rjw57/buri-bus-monitor/front-panel-mirror.pdf

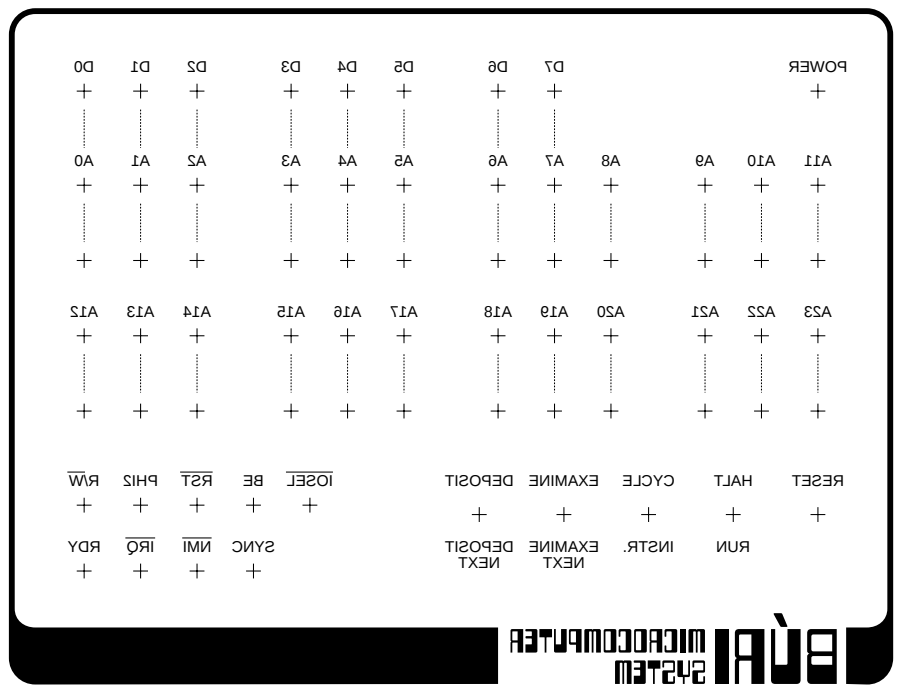
[picture p1: page 1]
