rjw57/buri-bus-monitor/front-panel.pdf

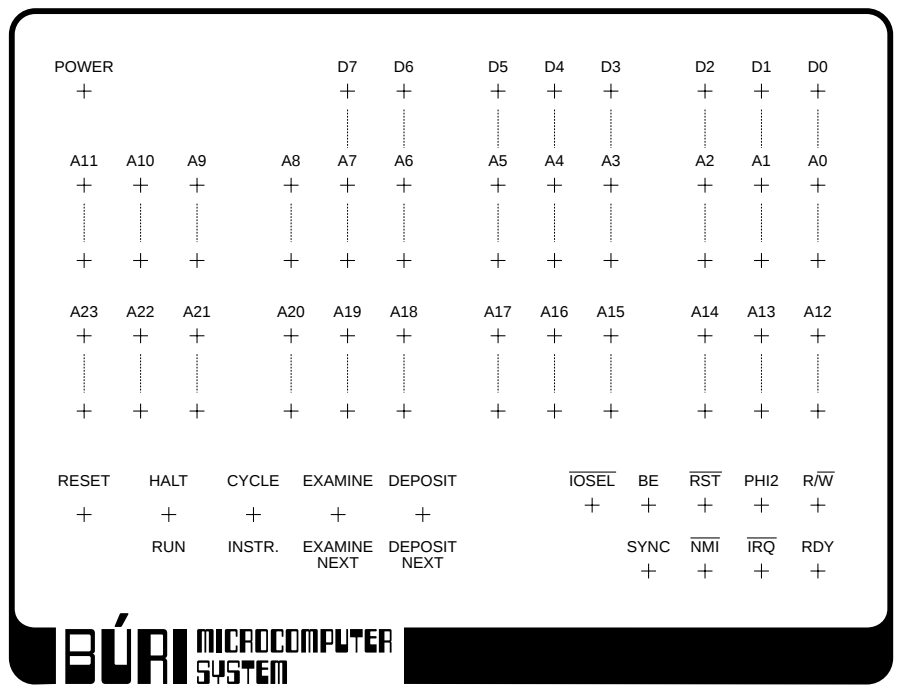
[picture p2: page 1]
