rjw57/buri-bus-monitor/plot/buri-bus-monitor.pdf

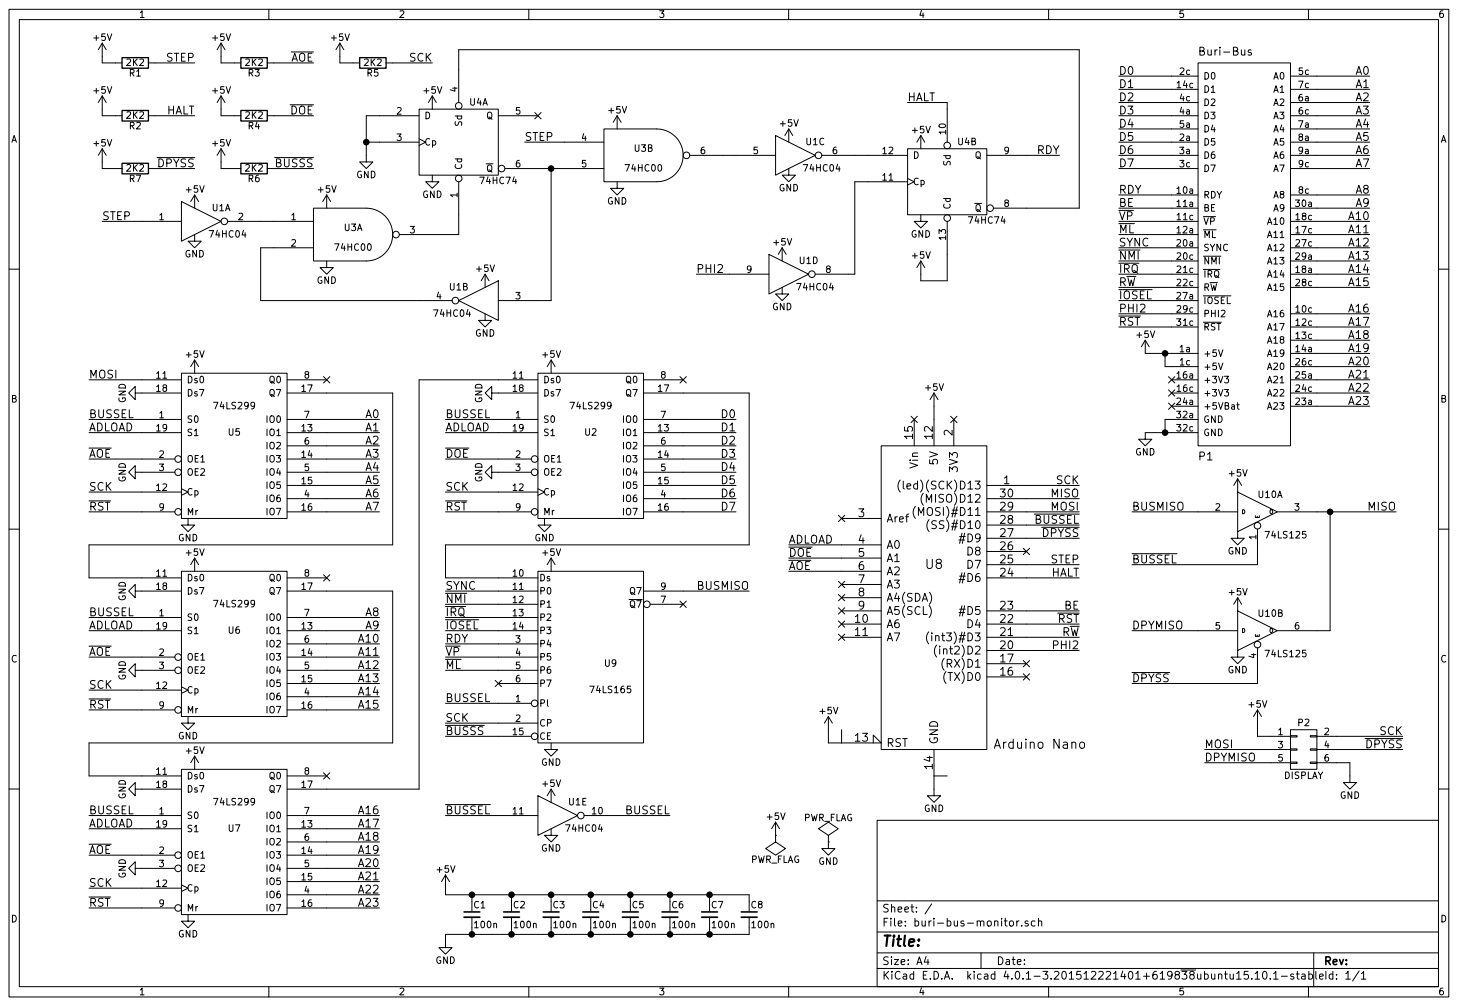
[picture p3: page 1]

Id: 1/1 Title: File: buri-bus-monitor.sch Sheet: /
