rjw57/buri-bus-monitor/plot/buri-bus-monitor-B.Cu.pdf

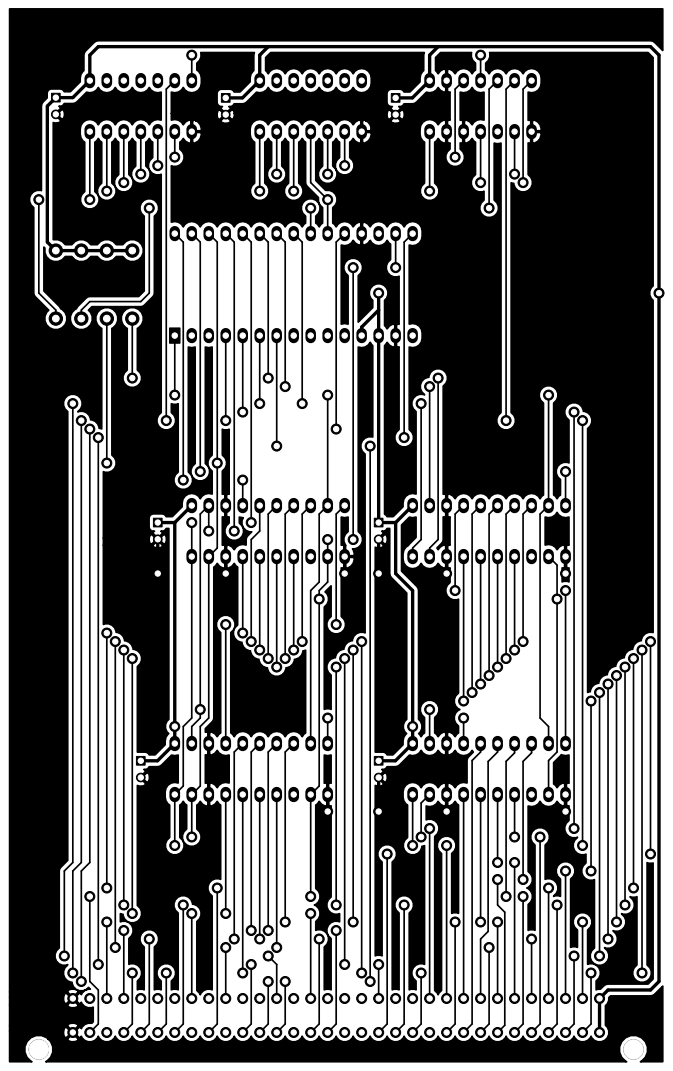
[picture p4: page 1]
