rjw57/buri-bus-monitor/plot/buri-bus-monitor-F.Cu.pdf

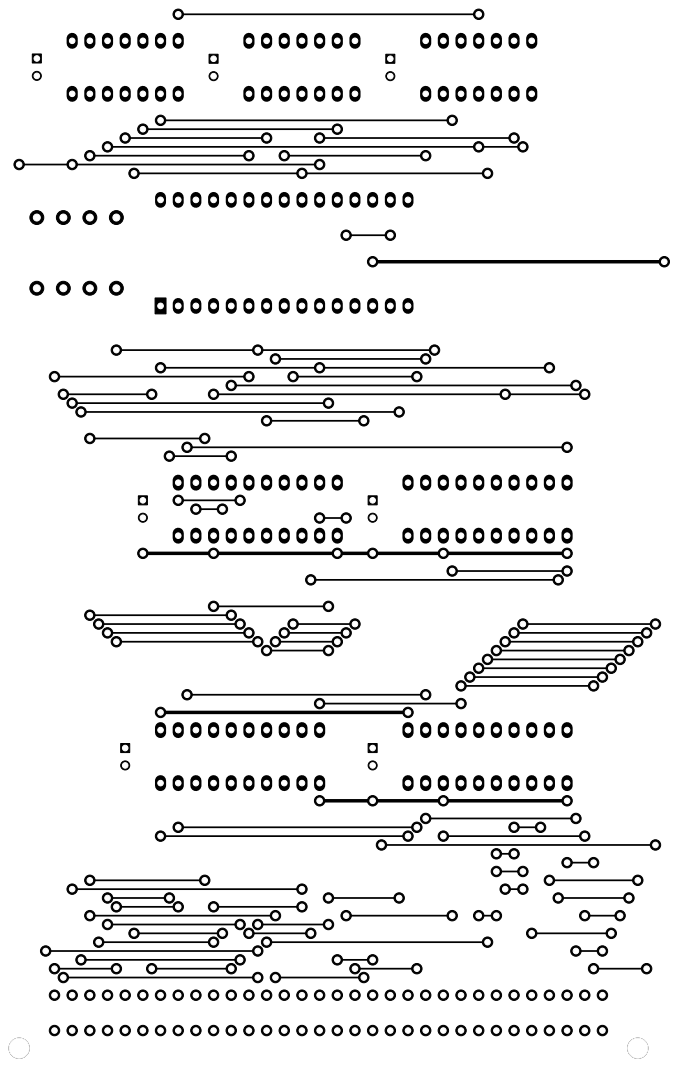
[picture p5: page 1]
