rjw57/buri-bus-monitor/plot/buri-bus-monitor-F.SilkS.pdf

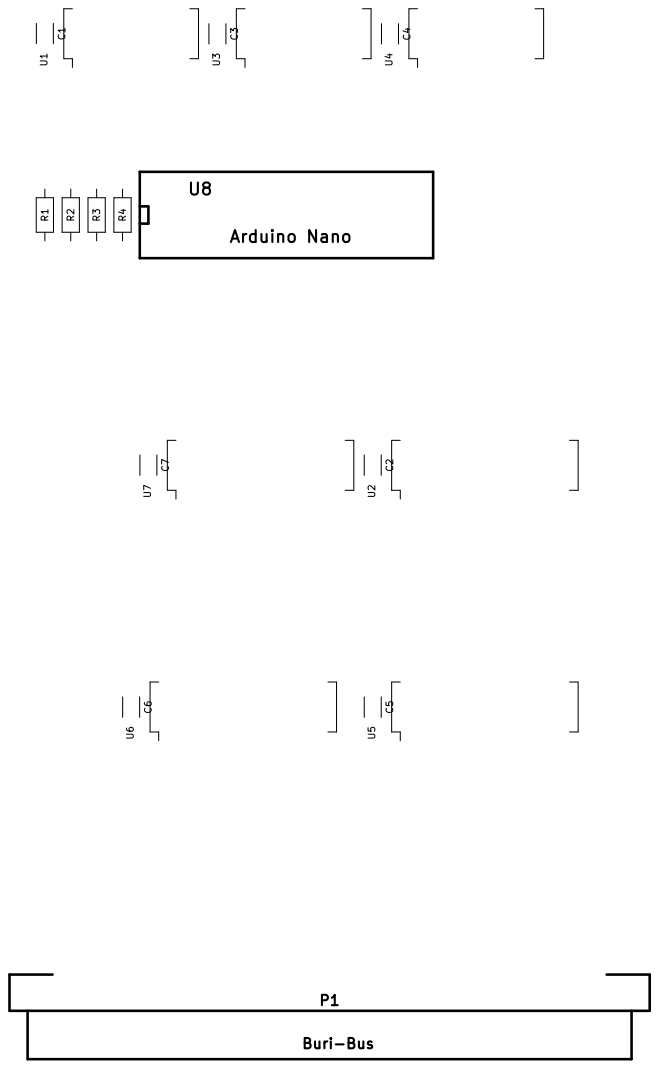
[picture p6: page 1]
