rjw57/buri-bus-monitor/buri-bus-monitor.kicad_pcb

## KiCad design buri-bus-monitor.kicad_pcb (2016-01-09)

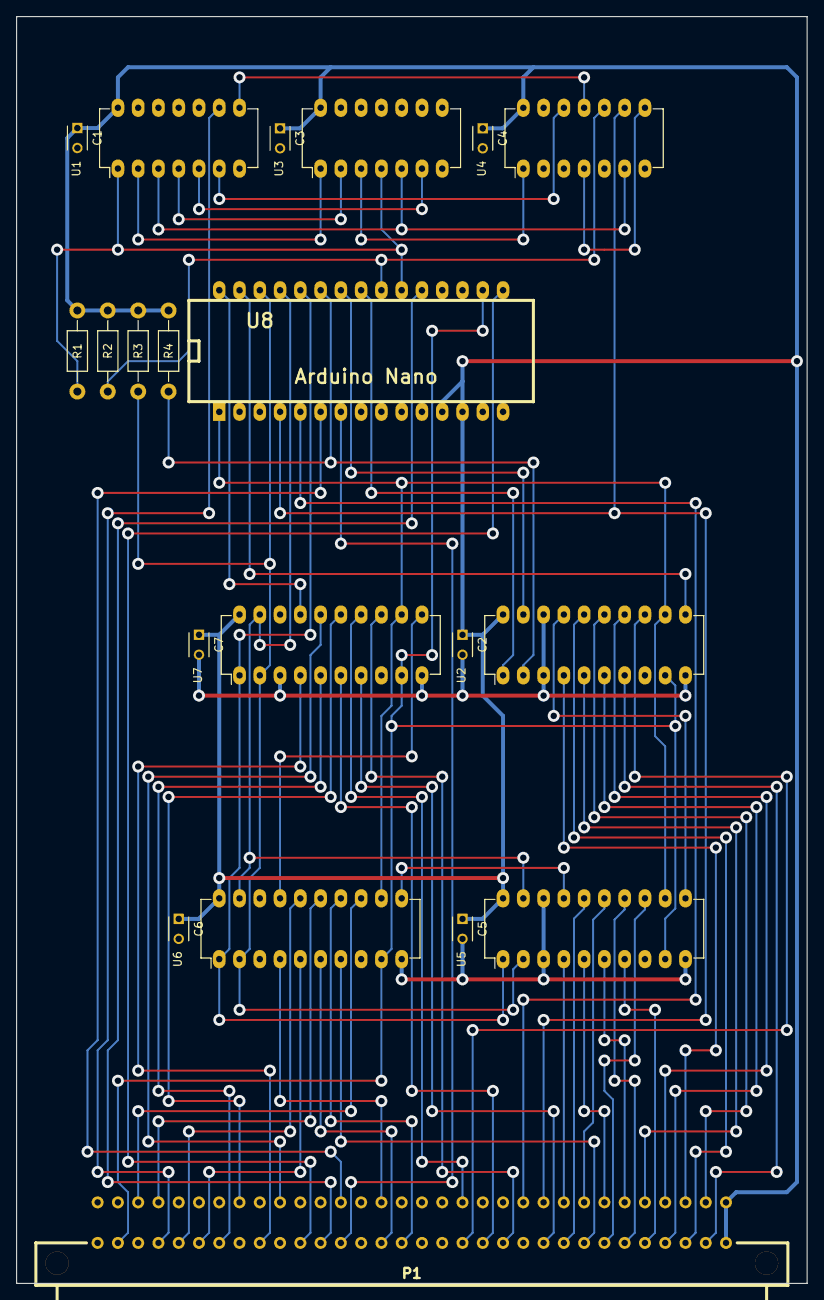
[picture p7: board buri-bus-monitor.kicad_pcb from above]

Board: 2 copper layers, 99.1 x 158.8 mm, 20 parts (0 on the bottom side), 64 nets.

Parts:
C1, C2, C3, C4, C5, C6, C7: 100n; C_Disc_D3_P2.5
P1: Buri-Bus; buri-bus-male
R1, R2, R3, R4: 3K3; Resistor_Horizontal_RM10mm
U1: 74HC04; DIP-14_W7.62mm_LongPads
U2, U5, U6, U7: 74LS299; DIP-20_W7.62mm_LongPads
U3: 74HC00; DIP-14_W7.62mm_LongPads
U4: 74HC74; DIP-14_W7.62mm_LongPads
U8: Arduino Nano; arduino_mini

Connections:
+5V: C1.1, C2.1, C3.1, C4.1, C5.1, C6.1, C7.1, P1.1a, P1.1c, R1.2, R2.2, R3.2, R4.2, U1.14, U2.20, U3.14, U4.13, U4.14, U5.20, U6.20, U7.20, U8.12, U8.13
/A0: P1.5c, U5.7
/A1: P1.7c, U5.13
/A2: P1.6a, U5.6
/A3: P1.6c, U5.14
/A4: P1.7a, U5.5
/A5: P1.8a, U5.15
/A6: P1.9a, U5.4
/A7: P1.9c, U5.16
/A8: P1.8c, U6.7
/A9: P1.30a, U6.13
/A10: P1.18c, U6.6
/A11: P1.17c, U6.14
/A12: P1.27c, U6.5
/A13: P1.29a, U6.15
/A14: P1.18a, U6.4
/A15: P1.28c, U6.16
/A16: P1.10c, U7.7
/A17: P1.12c, U7.13
/A18: P1.13c, U7.6
/A19: P1.14a, U7.14
/A20: P1.26c, U7.5
/A21: P1.25a, U7.15
/A22: P1.24c, U7.4
/A23: P1.23a, U7.16
/AS0: U5.1, U6.1, U7.1, U8.26
/AS1: U5.19, U6.19, U7.19, U8.27
/BE: P1.11a, U8.5
/D0: P1.2c, U2.7
/D1: P1.14c, U2.13
/D2: P1.4c, U2.6
/D3: P1.4a, U2.14
/D4: P1.5a, U2.5
/D5: P1.2a, U2.15
/D6: P1.3a, U2.4
/D7: P1.3c, U2.16
/DS0: U2.1, U8.23
/DS1: U2.19, U8.24
/HALT: R2.1, U4.10, U8.22
/MISO: U7.17, U8.30
/MOSI: U2.11, U8.29
/PHI2: P1.29c, U1.9
/RDY: P1.10a, U4.9, U8.4
/R~W: P1.22c, U8.16
/SCLK: U2.12, U5.12, U6.12, U7.12, U8.1
/STEP: R1.1, U1.1, U3.4, U8.21
/SYNC: P1.20a, U8.6
/~AOE: R3.1, U5.2, U6.2, U7.2, U8.28
/~DOE: R4.1, U2.2, U8.25
/~IRQ: P1.21c, U8.20
/~NMI: P1.20c, U8.7
/~RST: P1.31c, U2.9, U5.9, U6.9, U7.9, U8.17
GND: C1.2, C2.2, C3.2, C4.2, C5.2, C6.2, C7.2, P1.32a, P1.32c, U1.7, U2.3, U2.10, U2.18, U3.7, U4.2, U4.3, U4.7, U5.3, U5.10, U5.18, U6.3, U6.10, U6.18, U7.3, U7.10, U7.18, U8.14, U8.19
unnamed: U1.2, U3.1
unnamed: U1.3, U3.5, U4.6
unnamed: U1.4, U3.2
unnamed: U1.5, U3.6
unnamed: U1.6, U4.12
unnamed: U1.8, U4.11
unnamed: U2.17, U5.11
unnamed: U3.3, U4.1
unnamed: U4.4, U4.8
unnamed: U5.17, U6.11
unnamed: U6.17, U7.11
