rjw57/buri-bus-monitor/dumb-firmware/serialcli.cpp

#include "serialcli.h"

#include <stdlib.h>
#include <string.h>

#include "control.h"
#include "globals.h"
#include "serialstatemachine.h"

const int MAX_CMD_LEN = 127, MAX_TOKENS = 5;
byte cmd_buf[MAX_CMD_LEN+1];
byte* cmd_tokenv[MAX_TOKENS+1];
int cmd_len;

// Address to write next upload line to
unsigned int upload_addr;

// States
static SerialState readingCommandState(byte ch);

// Process command stored in cmd_buf and return state to transition to.
static SerialState processCommand();

// Print a brief usage summary to the serial port.
static void printHelp();

// EXTERNAL

SerialState startSerialPrompt() {
    // Reset current command
    cmd_buf[0] = '\0';
    cmd_len = 0;

    Serial.print("> ");
    return { .next = &readingCommandState };
}

// INTERNAL

const char hexDigits[] = "0123456789ABCDEF";
static void printByteHex(byte v) {
    Serial.print(hexDigits[(v>>4) & 0xF]);
    Serial.print(hexDigits[v & 0xF]);
}

static void printWordHex(unsigned int v) {
    printByteHex((v>>8) & 0xFF);
    printByteHex(v & 0xFF);
}

// Handle input from serial and update input_len/inpit_buf appropriately.
// Return true if command has been entered.
static bool lineEditor(byte ch, byte* input_buf, int &input_len) {
    switch(ch) {
        // handle backspace
        case 8:
        case 127:
            if(input_len > 0) {
                Serial.write(8);
                Serial.write(' ');
                Serial.write(8);
                input_len--;
                input_buf[input_len] = '\0';
            } else {
                // bell
                Serial.write(7);
            }
            break;

        // handle enter
        case 10:
        case 13:
            Serial.println("");
            return true;
            break;

        default:
            // Only accept printable chars.
            if(ch < 0x20) {
                // Bell
                Serial.write(7);
            } else if(input_len < MAX_CMD_LEN) {
                // Add character to command buffer
                input_buf[input_len] = ch;
                input_len++;
                input_buf[input_len] = '\0';

                // Echo character to output
                Serial.write(ch);
            } else {
                // Bell
                Serial.write(7);
            }
            break;
    }

    return false;
}

// State machine
static SerialState readingCommandState(byte ch) {
    if(lineEditor(ch, cmd_buf, cmd_len)) {
        return processCommand();
    }

    return { .next = &readingCommandState };
}

#if 0
static void processUploadLine() {
    // Iterate through cmd_buf parsing any hex chars
    bool high_nibble=true;
    byte current_byte=0;
    startMem();
    for(int n=0; (n < cmd_len) && (cmd_buf[n] != '\0'); ++n) {
        byte nibble=0, c=cmd_buf[n];

        if((c >= '0') && (c <= '9')) {
            nibble = c - '0';
        } else if((c >= 'A') && (c <= 'F')) {
            nibble = (c - 'A') + 10;
        } else if((c >= 'a') && (c <= 'f')) {
            nibble = (c - 'a') + 10;
        } else {
            // skip
            continue;
        }

        if(high_nibble) {
            current_byte |= (nibble << 4);
        } else {
            current_byte |= nibble;
            writeMem(upload_addr, current_byte);
            current_byte = 0;
            ++upload_addr;
        }

        high_nibble = !high_nibble;
    }
    stopMem();
}
#endif

#if 0
static SerialState readingUploadState(byte ch) {
    if(lineEditor(ch, cmd_buf, cmd_len)) {
        if(cmd_len == 0) {
            // empty
            cmd_len = 0; cmd_buf[0] = '\0';
            return startSerialPrompt();
        }

        // Process upload line
        processUploadLine();

        // Start next prompt
        printWordHex(upload_addr);
        Serial.print(" : ");
        cmd_len = 0; cmd_buf[0] = '\0';
    }

    return { .next = &readingUploadState };
}
#endif

static void printHelp() {
    Serial.println("?           - show brief help message");
    Serial.println("r[ead] a    - read byte from address");
    Serial.println("w[rite] a v - write byte value to address");
    Serial.println("d[ump] a n  - dump n bytes from address");
    Serial.println("h[alt]      - toggle halt state");
    Serial.println("p[rint]     - print current address/data bus");
#if 0
    Serial.println("c[ycle] [n] - single cycle n times");
    Serial.println("s[tep] [n]  - single step n times");
    Serial.println("reset       - toggle ~RST line");
    Serial.println("b[e]        - toggle BE line");
#endif
    Serial.println("");
    Serial.println("Specify decimal numbers with no prefix.");
    Serial.println("Specify hexadecimal numbers with $ prefix.");
}

// MODIFY cmd_buf tokenizing it into space-separated tokens skipping leading
// and trailing spaces. (Spaces are replaced with '\0'.) Update cmd_tokenv as
// pointers into cmd_buf for each token will NULL marking the end of the list.
static void tokenizeCmdBuf() {
    int next_tokenv_idx = 0;
    int ch_idx = 0;

    // Reset token vector
    cmd_tokenv[0] = NULL;

    while((next_tokenv_idx < MAX_TOKENS) && (ch_idx < cmd_len)) {
        // Skip to next non-space char
        for(; (ch_idx < cmd_len) && (cmd_buf[ch_idx] != '\0') &&
              (cmd_buf[ch_idx] == ' '); ++ch_idx) { }

        // Have we reached end of string without finding token?
        if((ch_idx == cmd_len) || (cmd_buf[ch_idx] == '\0')) {
            // yes, exit
            break;
        }

        // Record location of token and advance next_tokenv_idx
        cmd_tokenv[next_tokenv_idx] = &(cmd_buf[ch_idx]);
        ++next_tokenv_idx;

        // Start by assuming we won't find a token next time around
        cmd_tokenv[next_tokenv_idx] = NULL;

        // Advance to first space character or end of buffer
        for(;(ch_idx < cmd_len) && (cmd_buf[ch_idx] != '\0') &&
             (cmd_buf[ch_idx] != ' ')
            ;++ch_idx)
        { }

        // Write '\0' and advance ch_idx
        if(ch_idx < cmd_len) {
            cmd_buf[ch_idx] = '\0';
        }
        ++ch_idx;
    }

    // Reset command buffer length
    cmd_len = 0;

    // Ensure cmd_tokenv is terminated with a NULL come what may.
    cmd_tokenv[MAX_TOKENS] = NULL;
}

// return true if a == b or a == b[0]
static bool strprefixeq(const char* a, const char* b) {
    if((a[0] != '\0') && (a[0] == b[0]) && (a[1] == '\0')) {
        return true;
    }
    return !strcmp(a, b);
}

// Parse s as an integer and write result to l. Return true iff parsing
// succeeds.
static bool parseLong(const char* s, long* l) {
    char* end_ptr;
    int base = 10;

    // Are we parsing a hex number?
    if(s[0] == '$') {
        base = 16;
        ++s;
    }

    *l = strtol(s, &end_ptr, base);
    return (s[0] != '\0') && (*end_ptr == '\0');
}

// Parse and perform a single cycle/instruction command.
static void performStepCommand(bool is_inst_step) {
    long n=1; // default
    if(cmd_tokenv[1] != NULL) {
        const char* arg1 = reinterpret_cast<const char*>(cmd_tokenv[1]);
        if(!parseLong(arg1, &n)) {
            Serial.print("invalid number: ");
            Serial.println(arg1);
        }
    }

    for(long i=0; i<n; ++i) {
        if(!controlIsClaimed()) {
            Serial.println("aborting: processor not halted");
            return;
        }

        controlCycle();
    }


    /*
    for(long i=0; i<n; ++i) {
        step_state = is_inst_step ? SS_INST : SS_CYCLE;
        while(step_state != SS_NONE) {
            controlLoop();

            if(!processorCanBeStepped()) {
                Serial.println("aborting: processor in incorrect state for stepping");
                step_state = SS_NONE;
            }
        }
    }
    */
}

#if 0
// Handle "addr (off | <address>)" command for asserting address bus.
static void performAssertAddress() {
    const char* arg1 = reinterpret_cast<const char*>(cmd_tokenv[1]);
    if(strcmp(arg1, "off")) {
        // parse address value
        long v=0;
        if(!parseLong(arg1, &v)) {
            Serial.print("invalid address: ");
            Serial.println(arg1);
        }
        assert_address = true;
        out_address_bus = v;
    } else {
        // addr off - stop asserting
        assert_address = false;
    }
}
#endif

#if 0
// Handle "data (off | <value>)" command for asserting data bus.
static void performAssertData() {
    const char* arg1 = reinterpret_cast<const char*>(cmd_tokenv[1]);
    if(strcmp(arg1, "off")) {
        // parse address value
        long v=0;
        if(!parseLong(arg1, &v)) {
            Serial.print("invalid data: ");
            Serial.println(arg1);
        }
        assert_data = true;
        out_data_bus = v;
    } else {
        // data off - stop asserting
        assert_data = false;
    }
}
#endif

// perform the "write <addr> <val>" command
static void performWrite() {
    const char* arg1 = reinterpret_cast<const char*>(cmd_tokenv[1]);
    const char* arg2 = reinterpret_cast<const char*>(cmd_tokenv[2]);
    long a, d;

    if(!parseLong(arg1, &a)) {
        Serial.print("invalid address: ");
        Serial.println(arg1);
        return;
    }

    if(!parseLong(arg2, &d)) {
        Serial.print("invalid data: ");
        Serial.println(arg2);
        return;
    }

    controlWrite(a, d);
}

// perform the "read <addr>" command
static void performRead() {
    const char* arg1 = reinterpret_cast<const char*>(cmd_tokenv[1]);
    long v;

    if(!parseLong(arg1, &v)) {
        Serial.print("invalid address: ");
        Serial.println(arg1);
        return;
    }

    byte d = controlRead(v);

    Serial.print("D: $");
    Serial.print(d, HEX);
    Serial.println("");
}

static void performDump() {
    static uint8_t line[0x10];
    const char* arg1 = reinterpret_cast<const char*>(cmd_tokenv[1]);
    const char* arg2 = reinterpret_cast<const char*>(cmd_tokenv[2]);
    long addr, n;

    if(!parseLong(arg1, &addr)) {
        Serial.print("invalid address: ");
        Serial.println(arg1);
        return;
    }

    if(!parseLong(arg2, &n)) {
        Serial.print("invalid count: ");
        Serial.println(arg2);
        return;
    }

    for(long i=0; i<n; ++i) {
        if((i & 0xF) == 0x0) {
            printWordHex(addr + i);
            Serial.print(" : ");
        }

        line[i&0xF] = controlRead(addr + i);
        printByteHex(line[i&0xF]);
        Serial.print(' ');

        if((i & 0xF) == 0x7) {
            Serial.print(" ");
        }

        if((i & 0xF) == 0xF) {
            Serial.print(" |");
            for(int j=0; j<16; ++j) {
                byte c = line[j];
                if((c >= ' ') && (c <= '~')) {
                    Serial.print(static_cast<char>(c));
                } else {
                    Serial.print('.');
                }
            }
            Serial.println("|");
        }
    }

    if((n & 0xF) != 0) {
        Serial.println("");
    }
}

#if 0
static SerialState startUploadPrompt() {
    const char* arg1 = reinterpret_cast<const char*>(cmd_tokenv[1]);
    long addr;

    if(!parseLong(arg1, &addr)) {
        Serial.print("invalid address: ");
        Serial.println(arg1);
        return startSerialPrompt();
    }
    upload_addr = addr;

    printWordHex(upload_addr);
    Serial.print(" : ");
    cmd_len = 0; cmd_buf[0] = '\0';
    return { .next = &readingUploadState };
}
#endif

static SerialState processCommand() {
    // Parse cmd_buf into tokens
    tokenizeCmdBuf();

    // Count tokens
    int n_tokens = 0;
    for(; (cmd_tokenv[n_tokens] != NULL) && (n_tokens < MAX_TOKENS)
        ; ++n_tokens) {}

    // Pull out command name
    const char *cmd = reinterpret_cast<const char*>(cmd_tokenv[0]);

    if(n_tokens == 0) {
        // If no command was given, print help
        printHelp();
    } else if(strprefixeq(cmd, "?") && (n_tokens == 1)) {
        // If help command was given, print help
        printHelp();
    } else if(strprefixeq(cmd, "read") && (n_tokens == 2)) {
        performRead();
    } else if(strprefixeq(cmd, "write") && (n_tokens == 3)) {
        performWrite();
    } else if(strprefixeq(cmd, "dump") && (n_tokens == 3)) {
        performDump();
    } else if(strprefixeq(cmd, "halt") && (n_tokens == 1)) {
        int should_halt = !controlIsHalted();
        controlSetHalt(should_halt);
        Serial.print("halt ");
        Serial.println(should_halt ? "on" : "off");
    } else if(strprefixeq(cmd, "print") && (n_tokens == 1)) {
        // print current state
        ControlBusState read_state;
        read_state = controlUpdateBus(read_state);
        Serial.print("A: $");
        Serial.print(read_state.address, HEX);
        Serial.print(" D: $");
        Serial.print(read_state.data, HEX);
        Serial.println("");
        Serial.print("SYNC: ");
        Serial.println(read_state.ro_control.flags.sync);
    } else if(strprefixeq(cmd, "cycle") && (n_tokens <= 2)) {
        performStepCommand(false);
    } else if(strprefixeq(cmd, "step") && (n_tokens <= 2)) {
        performStepCommand(true);
#if 0
    } else if(!strcmp(cmd, "reset") && (n_tokens == 1)) {
        pull_rst_low = !pull_rst_low;
        Serial.print("~rst ");
        Serial.println(pull_rst_low ? "low" : "high");
    } else if(strprefixeq(cmd, "be") && (n_tokens == 1)) {
        pull_be_low = !pull_be_low;
        Serial.print("be ");
        Serial.println(pull_be_low ? "low" : "high");
    } else if(!strcmp(cmd, "rw") && (n_tokens == 1)) {
        // undocumented rw command
        pull_rwbar_low = !pull_rwbar_low;
        Serial.print("rwbar ");
        Serial.println(pull_rwbar_low ? "low" : "high");
    } else if(!strcmp(cmd, "addr") && (n_tokens == 2)) {
        // undocumented "addr" command for testing
        performAssertAddress();
    } else if(!strcmp(cmd, "data") && (n_tokens == 2)) {
        // undocumented "data" command for testing
        performAssertData();
    } else if(strprefixeq(cmd, "upload") && (n_tokens == 2)) {
        return startUploadPrompt();
#endif
    } else {
        Serial.println("unknown command");
        printHelp();
    }

    return startSerialPrompt();
}
