rjw57/buri-bus-monitor/dumb-firmware/globals.h

// The very name of this file should provoke dread in the hearts of All True
// Developers. That being said, having global state like this is just an
// application of the zero, one, many rule with the earnest hope that one is
// sufficiently many.

#pragma once
#ifndef GUARD_GLOBALS_H
#define GUARD_GLOBALS_H

#include <Arduino.h> // for "byte"

#endif // GUARD_GLOBALS_H
