rjw57/buri-bus-monitor/firmware/mx7219.h

// Utilities for MX7219 chip
#pragma once
#ifndef GUARD_MX7219_H__
#define GUARD_MX7219_H__

// MAX7219 registers.
#define MX7219_NOP          0x0
#define MX7219_DIGIT_0      0x1
#define MX7219_DECODE_MODE  0x9
#define MX7219_INTENSITY    0xA
#define MX7219_SCN_LIMIT    0xB
#define MX7219_SHUTDOWN     0xC
#define MX7219_DPLY_TEST    0xF

#endif // GUARD_MX7219_H__
