rjw57/buri-bus-monitor/(commit log)

2016-01-09 first version
    [buri-bus-monitor.kicad_pcb, buri-bus-monitor.sch]
2016-01-09 first pass at layout
    [buri-bus-monitor.kicad_pcb, buri-bus-monitor.sch]
2016-01-09 add plots
    [buri-bus-monitor.kicad_pcb]
2016-01-09 regenerate ground fill
    [buri-bus-monitor.kicad_pcb]
2016-01-09 correct single step logic
    [buri-bus-monitor.kicad_pcb, buri-bus-monitor.sch]
2016-01-11 Add input for non data/address bus
    [buri-bus-monitor.sch]
2016-01-11 Update LSB first shift regs
    [buri-bus-monitor.sch]
2016-01-11 move display control to SDA/SCK pins
    [buri-bus-monitor.sch]
2016-01-11 rearrange pins on Arduino
    [buri-bus-monitor.sch]
2016-01-11 Make firmware compatible with Arduino IDE
2016-01-12 add Makefile using Arduino IDE CLI
2016-01-12 Convert display to SPI
    [buri-bus-monitor.sch]
2016-01-12 Re-order bus pins on '165 to match current hardware
    [buri-bus-monitor.sch]
2016-01-12 Coalesce AS0 and DS0 lines
    [buri-bus-monitor.sch]
2016-01-13 wire up bus signal control lines
    [buri-bus-monitor.sch]
2016-01-13 Add notes on SPI protocol for bus
2016-01-13 Fix markdown syntax for SPI protocol
2016-01-13 updae front panel with lessons from prototype 1
2016-01-24 update SPI bus monitor interface to be MSB first
    [buri-bus-monitor.sch]
2016-01-26 add HALT and RESET support
    [firmware.ino, mx7219.h, pins.h, serialcli.cpp]
